robotronik/robot-sumo/mecanique/freecad_model/robot_sumo_CN70_holder_part.fcstd

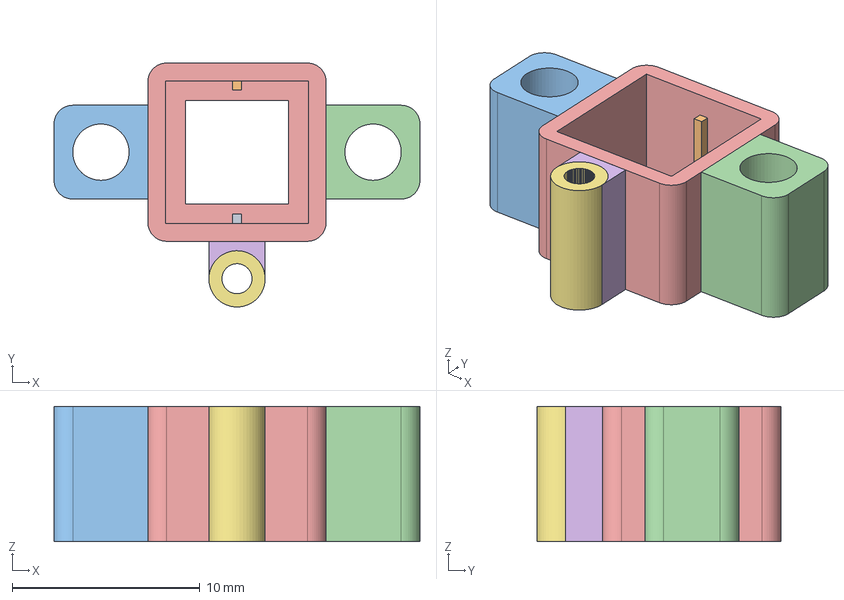
[picture p1: CAD file, 2017-09-19]
mecanique/freecad_model/robot_sumo_CN70_holder_part.fcstd
19.5 x 13.0 x 7.20 mm
sensor_guidance_1
sensor_guidance_2
