robotronik/robot-sumo/mecanique/robot-sumo-stl/support_pololu_3-8inch_ball_caster.stl

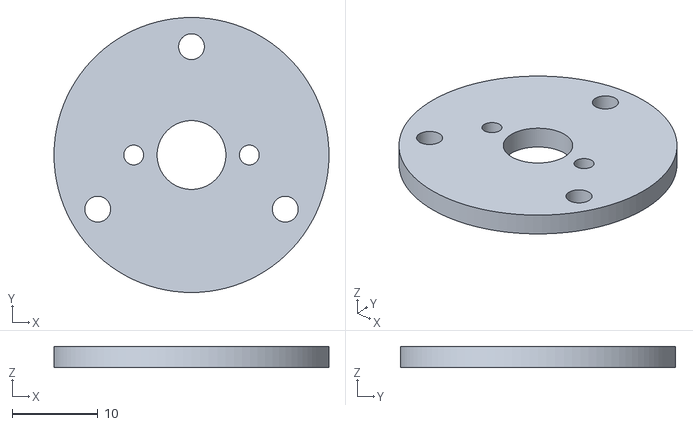
[picture p2: CAD file, 2017-09-06]
mecanique/robot-sumo-stl/support_pololu_3-8inch_ball_caster.stl
32.0 x 32.0 x 2.50
