robotronik/robot-sumo/mecanique/freecad_model/robot_sumo_motor_fix.fcstd

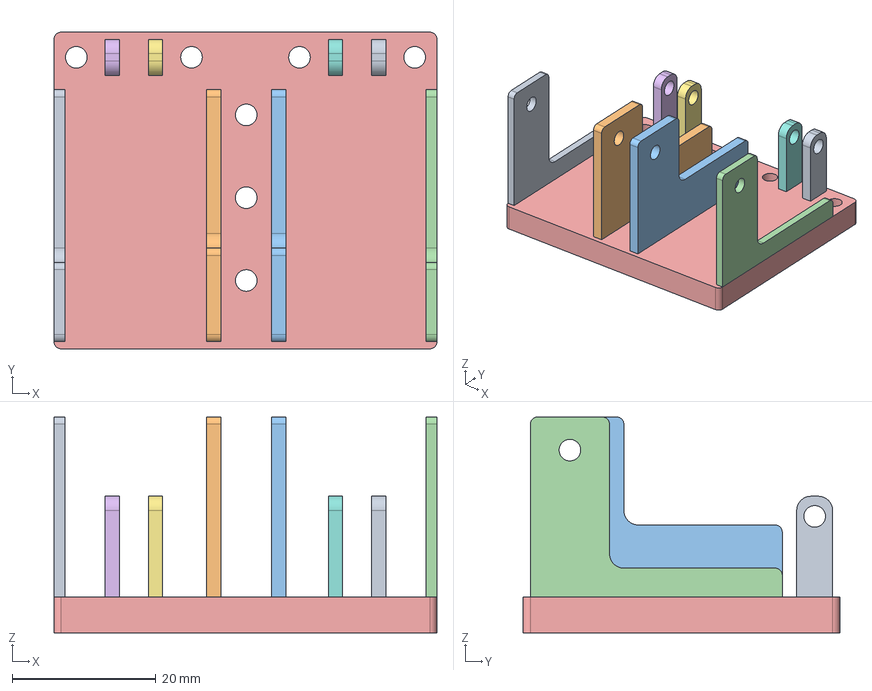
[picture p3: CAD file, 2017-07-28]
mecanique/freecad_model/robot_sumo_motor_fix.fcstd
53.2 x 44.0 x 30.0 mm
