robotronik/robot-sumo/mecanique/freecad_model/robot_sumo_CN70_block_part.fcstd

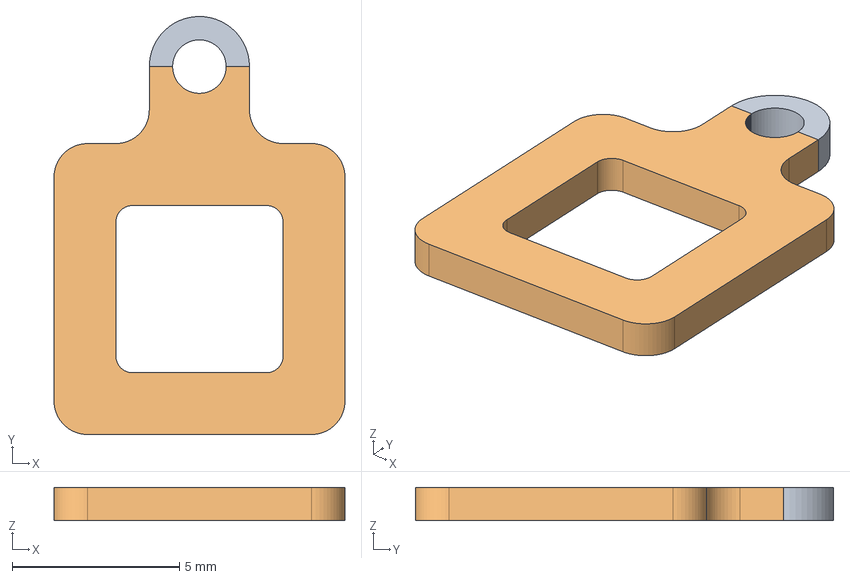
[picture p4: CAD file, 2017-07-26]
mecanique/freecad_model/robot_sumo_CN70_block_part.fcstd
8.70 x 12.5 x 1.00 mm
