robotronik/robot-sumo/mecanique/freecad_model/robot_sumo_base.fcstd

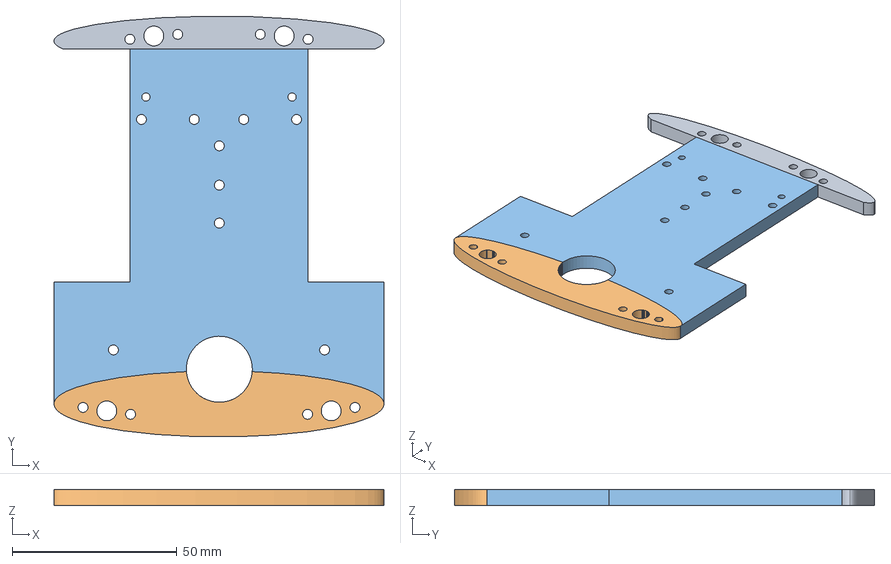
[picture p5: CAD file, 2017-07-25]
mecanique/freecad_model/robot_sumo_base.fcstd
100.0 x 127.4 x 5.00 mm
front_color_sensor_fix_holes
