robotronik/robot-sumo/mecanique/support_capteur_US_v2.scad

$fn=100;
use <capteurUS_HCSR04.scad>;
use <BezierScad/BezierScad.scad>

%translate([7.45,1,5])mirror([0,0,0])import ("freecad_model/robot_sumo_US_sensor_holder.stl");

//new fix 2017

diam_vis=1.5;

module backplate(L,H,e){

     difference(){
	  union(){
	       translate([-2,-(H-21),0])cube([L,H,e]);
	       translate([0.85,0.85,0])cylinder(d=diam_vis+2,h=e+2);
	       translate([45-0.85,0.85,0])cylinder(d=diam_vis+2,h=e+2);
	       translate([0.85,20-0.85,0])cylinder(d=diam_vis+2,h=e+2);
	       translate([45-0.85,20-0.85,0])cylinder(d=diam_vis+2,h=e+2);
	  }
	  minkowski(){
	       translate([(45-17)/2,-3.5+0.1+21,-0.1])cube([17,3.5,e+0.2]); // not interference with header
	       cylinder(d=3,h=e+0.2);
	  }
	  // screw hole
	  translate([0.85,0.85,-0.1])cylinder(d=diam_vis,h=e+2.2);
	  translate([45-0.85,0.85,-0.1])cylinder(d=diam_vis,h=e+2.2);
	  translate([0.85,20-0.85,-0.1])cylinder(d=diam_vis,h=e+2.2);
	  translate([45-0.85,20-0.85,-0.1])cylinder(d=diam_vis,h=e+2.2);
	  minkowski(){
	  translate([(45-30)/2,21-10-H/2+3,-0.1])cube([30,10,e+0.2]); // less PLA used
	  cylinder(d=2,h=e+0.2);
	  }
     }

     // fixation backplate

     translate([-2,-(H-18),0])cube([L,3,e]);
     difference(){
	  union(){
	       translate([-2,-(H-18),-10.5])cube([5,e,10.5]);
	       translate([-7+L,-(H-18),-10.5])cube([5,e,10.5]);
	  }
	  translate([0.35,0,-7.5])rotate([90,0,0])cylinder(d=2.5,h=10);
	  translate([-4.35+L,0,-7.5])rotate([90,0,0])cylinder(d=2.5,h=10);
	  
     }
}

module cable_management(L,l,h,e){

     cube([L,l,e]);
     cube([2,h,e]);
     translate([0,h,0])cube([L-2,e,e]);

}

module frontplate(L,H,e){
     difference(){
	  
	       union(){
		    minkowski(){
	       translate([-2,-(H-21),0])cube([L,H,e]);
	       cylinder(d=1.5,h=0.001);
	       }
	       translate([0.85,0.85,-3.5])cylinder(d=diam_vis+2,h=e+2);
	       translate([45-0.85-1,0.85,-3.5])cylinder(d=diam_vis+2,h=e+2);
	       translate([0.85,20-0.85,-3.5])cylinder(d=diam_vis+2,h=e+2);
	       translate([45-0.85-1,20-0.85,-3.5])cylinder(d=diam_vis+2,h=e+2);
	       translate([-2,-(H-18),0])cube([L,3,e]);
	  }

	  // screw hole
	  translate([0.85,0.85,-0.1-3.5])cylinder(d=diam_vis,h=e+2.2+3);
	  translate([45-0.85-1,0.85,-0.1-3.5])cylinder(d=diam_vis,h=e+2.2+3);
	  translate([0.85,20-0.85,-0.1-3.5])cylinder(d=diam_vis,h=e+2.2+3);
	  translate([45-0.85-1,20-0.85,-0.1-3.5])cylinder(d=diam_vis,h=e+2.2+3);
	  translate([45/2,10,-0.1])rotate([0,0,-90])cylinder(d=7,h=e+0.2,$fn=3); // decoration ^^
	  
	  translate([42.5,0,-0.1])rotate([0,0,-90])linear_extrude(height = e+0.2) 
	  BezLine([
	     [0,-12], [5, -20], [0,-28]
	     ], width = [3, 3], resolution = 5, centered = true);
	  
	      translate([9.5,10,-0.1]) cylinder(d=18,h=e+0.2);
	      translate([45-9.5,10,-0.1]) cylinder(d=18,h=e+0.2);
	  }

     // fixation frontplate

     
     difference(){
	  union(){
	       translate([-2,-(H-18),-15.5])cube([5,e,15.5]);
	       translate([-7+L,-(H-18),-15.5])cube([5,e,15.5]);
	       translate([-8,5,0])cable_management(6,2,7,2);
	       translate([L+4,5,0])mirror([1,0,0])cable_management(6,2,7,2);
	  }
	  translate([0.35,0,-7.5-5])rotate([90,0,0])cylinder(d=2.5,h=10);
	  translate([-4.35+L,0,-7.5-5])rotate([90,0,0])cylinder(d=2.5,h=10);
	  
     }
     
}

//capteurUS_HCSR04(100);
//translate([0,0,-4])backplate(49,23,2);
translate([0,0,5])frontplate(48,23,2);
//#translate([0,0,7])cube([5,5,5]);
