robotronik/robot-sumo/mecanique/support_pololu_3-8inch_ball_caster.scad

$fn=100;

module support_pololu_951_ball_caster(e,H){

     difference(){
     union(){	
	  cylinder(d=32,h=e);
	  translate([0,0,0])rotate([0,0,0])cylinder(d=8,h=e+H);
	  	   translate([1.65+2.3/2-19.05/2,0,0])cylinder(d=2.3+2,h=e+H);
	       translate([19.05/2-(1.65+2.3/2),0,0])cylinder(d=2.3+2,h=e+H);
	}
	  translate([0,0,0])rotate([0,0,0]){
	       for(i=[0:2]){translate([12.6*cos(i*120-30),12.6*sin(i*120-30),-0.01])cylinder(d=3,h=e+0.02);
	       }

	       translate([1.65+2.3/2-19.05/2,0,-0.01])cylinder(d=2.3,h=10.16+0.02);
	       translate([19.05/2-(1.65+2.3/2),0,-0.01])cylinder(d=2.3,h=10.16+0.02);
	       
	  }
	  

     }
     
     
}

support_pololu_951_ball_caster(2.5,3);
