robotronik/robot-sumo/(list of files, cad)

Other CAD files:
mecanique/Support_capteurCNY70.scad
mecanique/support_moteur_v2.scad
