robotronik/robot-sumo/electronique/PCB/Robot_sumo.kicad_pcb

## KiCad design electronique/PCB/Robot_sumo.kicad_pcb (2017-09-20)

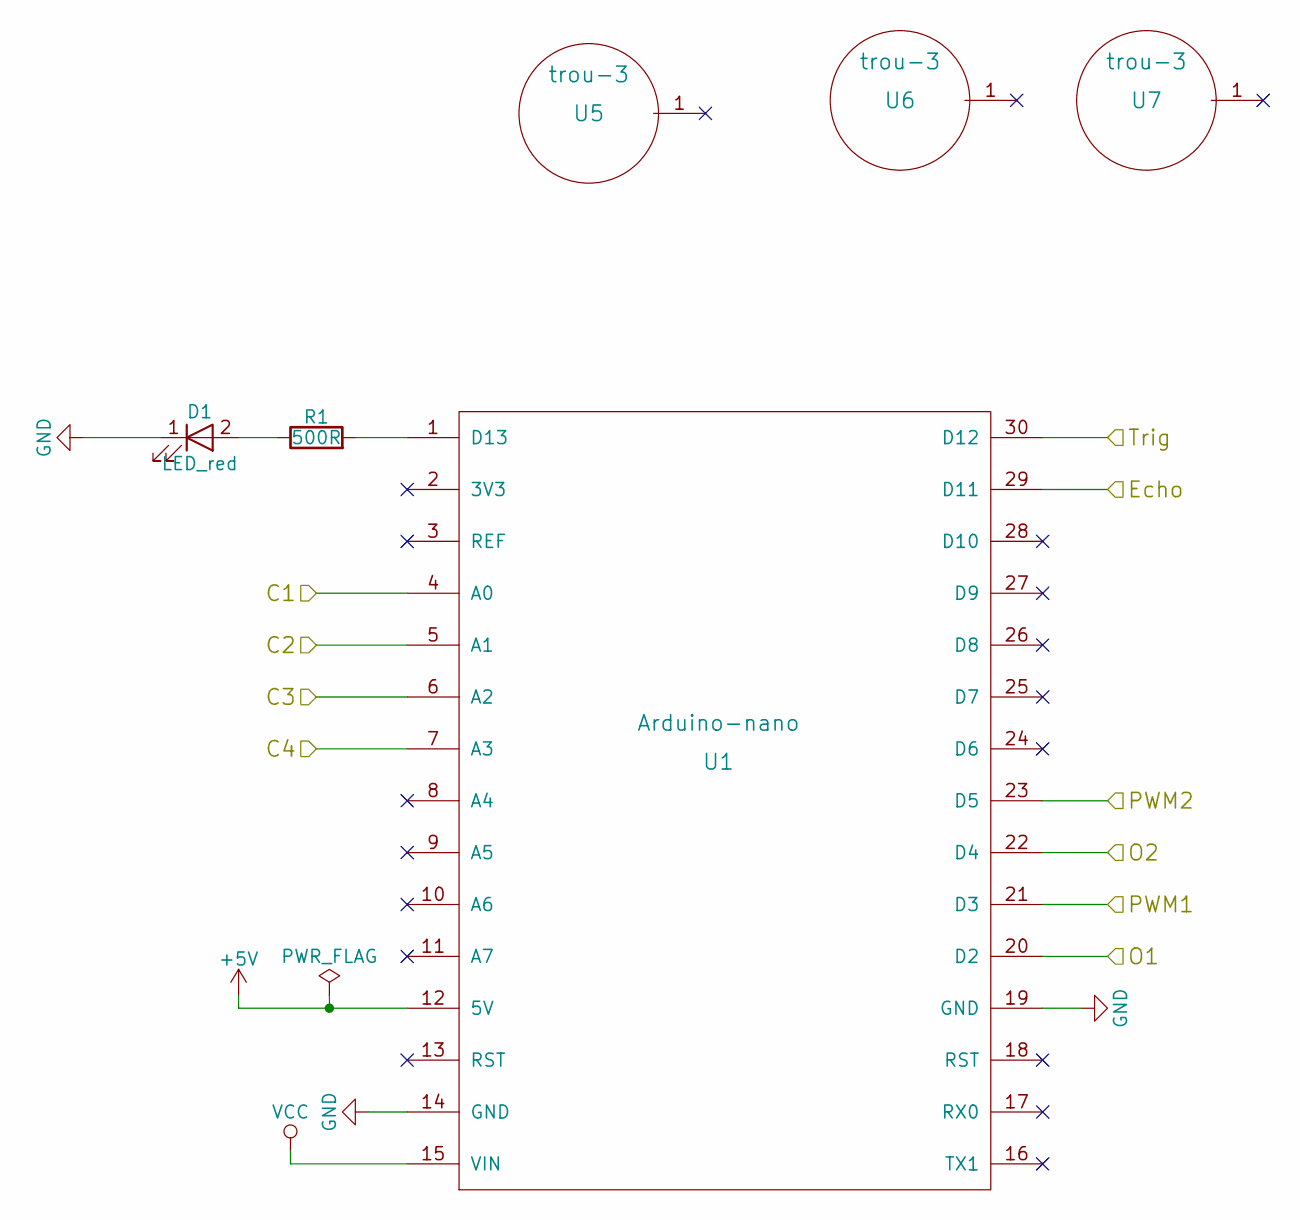
[picture p6: schematic uC-part.sch]

Parts:
D1: LED_red; LED_D5.0mm
R1: 500R; R4-LARGE_PADS
U1: Arduino-nano
U5, U6, U7: trou-3; Trou-3

Connections:
+5V: U1.12 (5V); also elsewhere on the board
/R-IR/C1: U1.4 (A0); also elsewhere on the board
/R-IR/C2: U1.5 (A1); also elsewhere on the board
/R-IR/C3: U1.6 (A2); also elsewhere on the board
/R-IR/C4: U1.7 (A3); also elsewhere on the board
/distance_sensor/Echo: U1.29 (D11); also elsewhere on the board
/distance_sensor/Trig: U1.30 (D12); also elsewhere on the board
/motor-part/O1: U1.20 (D2); also elsewhere on the board
/motor-part/O2: U1.22 (D4); also elsewhere on the board
/motor-part/PWM1: U1.21 (D3); also elsewhere on the board
/motor-part/PWM2: U1.23 (D5); also elsewhere on the board
GND: D1.1 (K), U1.14 (GND), U1.19 (GND); also elsewhere on the board
unnamed: D1.2 (A), R1.1
unnamed: R1.2, U1.1 (D13)
VCC: U1.15 (VIN); also elsewhere on the board

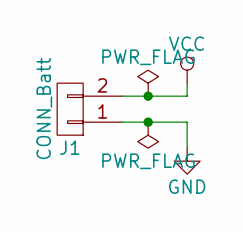
[picture p7: schematic power-part.sch]

Parts:
J1: CONN_Batt; Molex_KK-6410-02_02x2.54mm_Straight

Connections:
GND: J1.1; also elsewhere on the board
VCC: J1.2; also elsewhere on the board

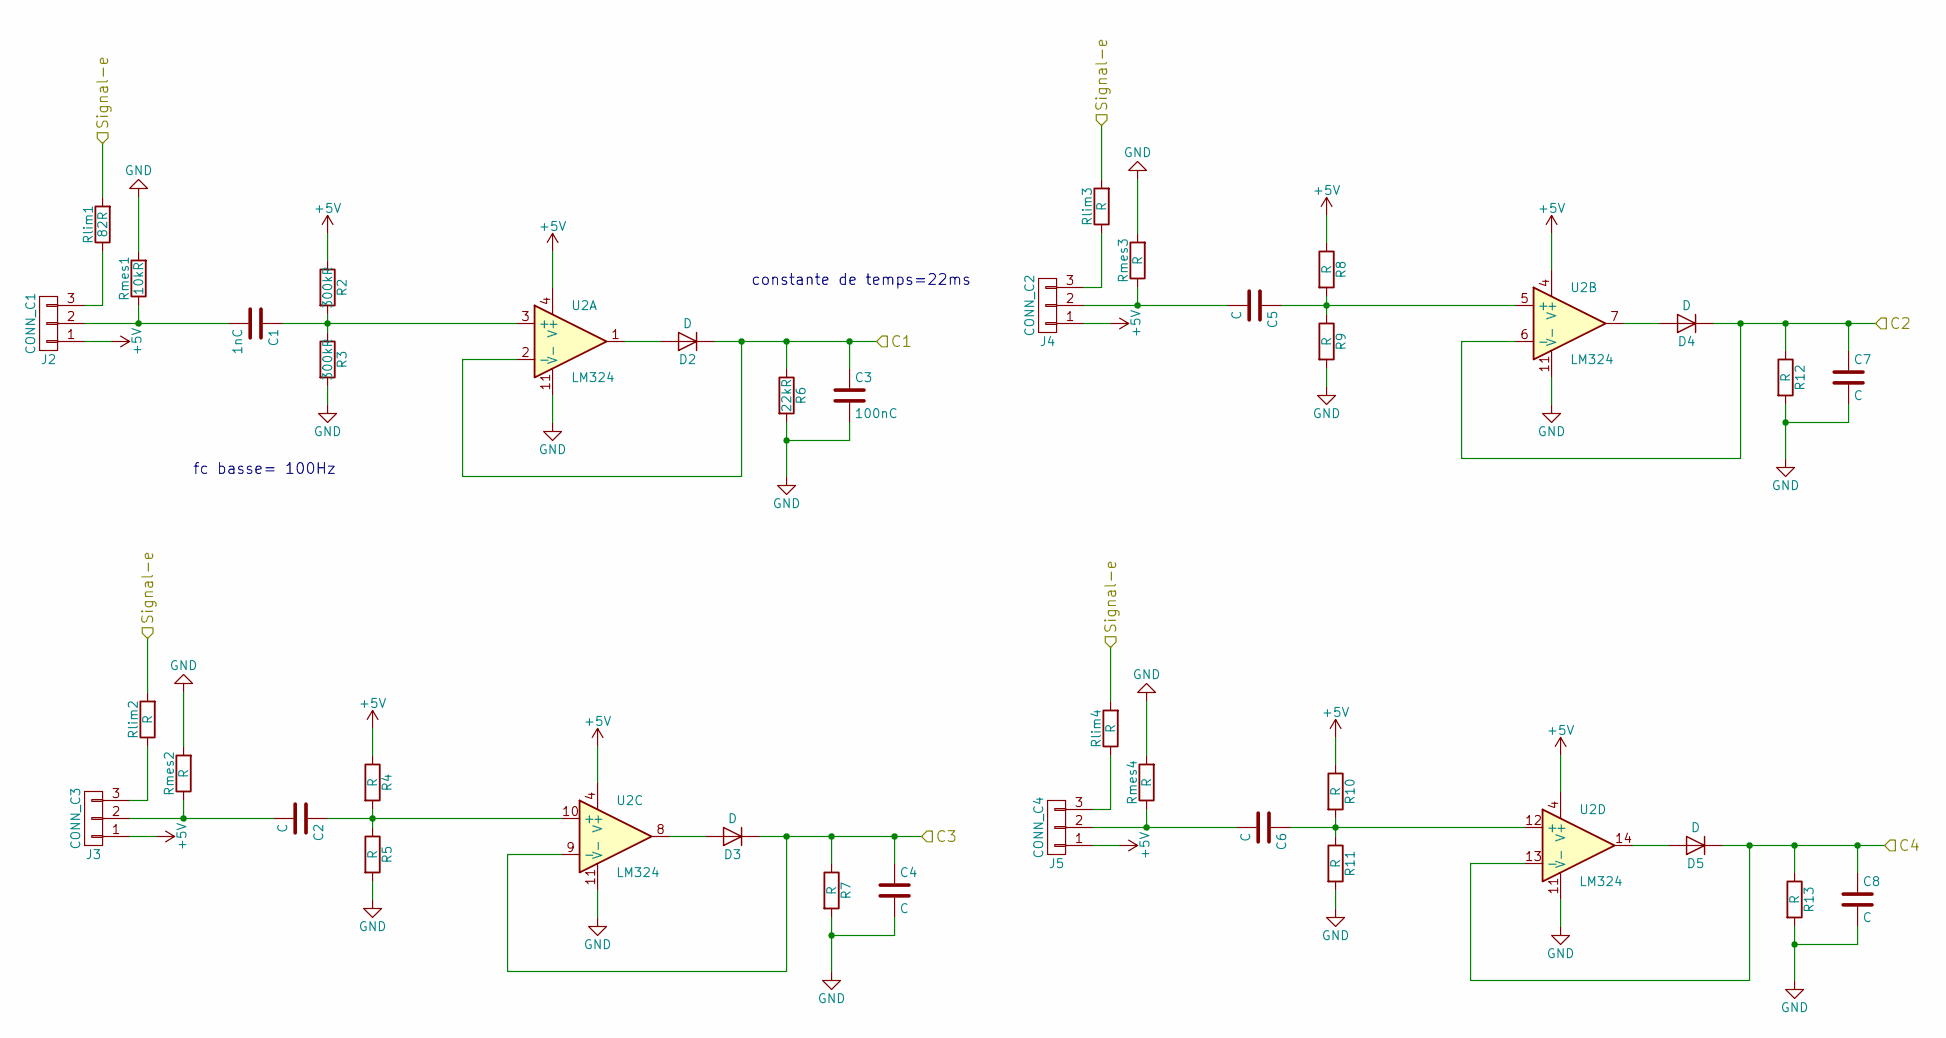
[picture p8: schematic R-IR.sch]

Parts:
C1: 1nC; C_Rect_L7.0mm_W2.5mm_P5.00mm
C2, C4, C5, C6, C7, C8: C; C_Rect_L7.0mm_W2.5mm_P5.00mm
C3: 100nC; C_Rect_L7.0mm_W2.5mm_P5.00mm
D2, D3, D4, D5: D; D4
J2: CONN_C1; Molex_KK-6410-03_03x2.54mm_Straight
J3: CONN_C3; Molex_KK-6410-03_03x2.54mm_Straight
J4: CONN_C2; Molex_KK-6410-03_03x2.54mm_Straight
J5: CONN_C4; Molex_KK-6410-03_03x2.54mm_Straight
R2, R3: 300kR; R4-LARGE_PADS
R4, R5, R7, R8, R9, R10, R11, R12, R13: R; R4-LARGE_PADS
R6: 22kR; R4-LARGE_PADS
Rlim1: 82R; R4-LARGE_PADS
Rlim2, Rlim3, Rlim4: R; R4-LARGE_PADS
Rmes1: 10kR; R4-LARGE_PADS
Rmes2, Rmes3, Rmes4: R; R4-LARGE_PADS
U2: LM324; DIP-14_W7.62mm_Socket_LongPads

Connections:
+5V: J2.1, J3.1, J4.1, J5.1, R2.1, R4.1, R8.1, R10.1, U2.4 (V+); also elsewhere on the board
/R-IR/C1: C3.1, D2.1 (K), R6.1, U2.2 (-); also elsewhere on the board
/R-IR/C2: C7.1, D4.1 (K), R12.1, U2.6 (-); also elsewhere on the board
/R-IR/C3: C4.1, D3.1 (K), R7.1, U2.9 (-); also elsewhere on the board
/R-IR/C4: C8.1, D5.1 (K), R13.1, U2.13 (-); also elsewhere on the board
/R-IR/Signal-e: Rlim1.2, Rlim2.2, Rlim3.2, Rlim4.2; also elsewhere on the board
GND: C3.2, C4.2, C7.2, C8.2, R3.2, R5.2, R6.2, R7.2, R9.2, R11.2, R12.2, R13.2, Rmes1.2, Rmes2.2, Rmes3.2, Rmes4.2, U2.11 (V-); also elsewhere on the board
unnamed: C1.1, R2.2, R3.1, U2.3 (+)
unnamed: C1.2, J2.2, Rmes1.1
unnamed: C2.1, R4.2, R5.1, U2.10 (+)
unnamed: C2.2, J3.2, Rmes2.1
unnamed: C5.1, R8.2, R9.1, U2.5 (+)
unnamed: C5.2, J4.2, Rmes3.1
unnamed: C6.1, R10.2, R11.1, U2.12 (+)
unnamed: C6.2, J5.2, Rmes4.1
unnamed: D2.2 (A), U2.1
unnamed: D3.2 (A), U2.8
unnamed: D4.2 (A), U2.7
unnamed: D5.2 (A), U2.14
unnamed: J2.3, Rlim1.1
unnamed: J3.3, Rlim2.1
unnamed: J4.3, Rlim3.1
unnamed: J5.3, Rlim4.1

Notes on the sheet:
fc basse= 100Hz
constante de temps=22ms

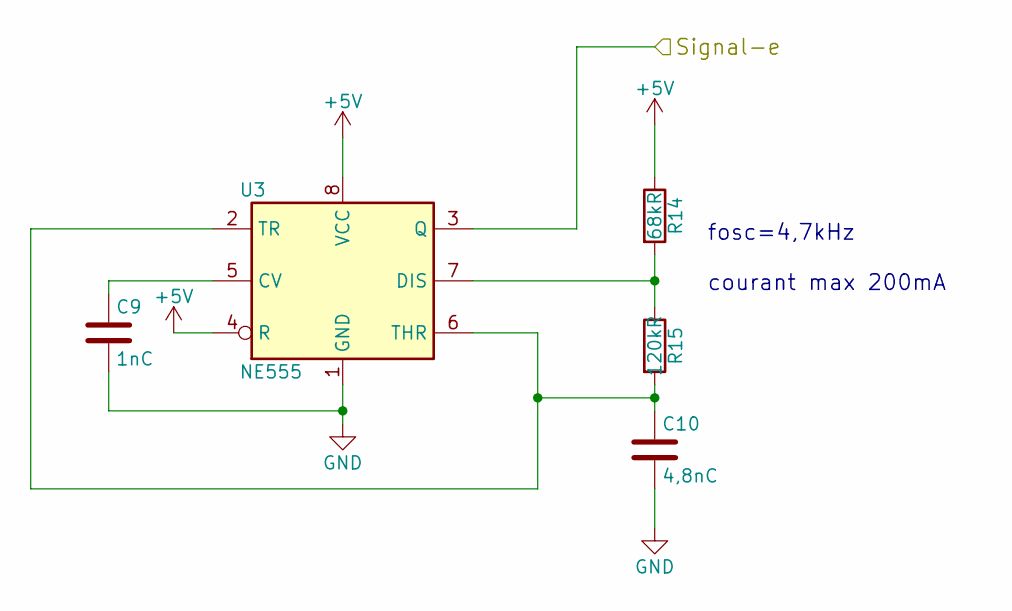
[picture p9: schematic T-IR.sch]

Parts:
C9: 1nC; C_Rect_L7.0mm_W2.5mm_P5.00mm
C10: 4,8nC; C_Rect_L7.0mm_W2.5mm_P5.00mm
R14: 68kR; R4-LARGE_PADS
R15: 120kR; R4-LARGE_PADS
U3: NE555; DIP-8_W7.62mm_Socket_LongPads

Connections:
+5V: R14.1, U3.4 (R), U3.8 (VCC); also elsewhere on the board
/R-IR/Signal-e: U3.3 (Q); also elsewhere on the board
GND: C9.2, C10.2, U3.1 (GND); also elsewhere on the board
unnamed: C9.1, U3.5 (CV)
unnamed: C10.1, R15.2, U3.2 (TR), U3.6 (THR)
unnamed: R14.2, R15.1, U3.7 (DIS)

Notes on the sheet:
fosc=4,7kHz courant max 200mA

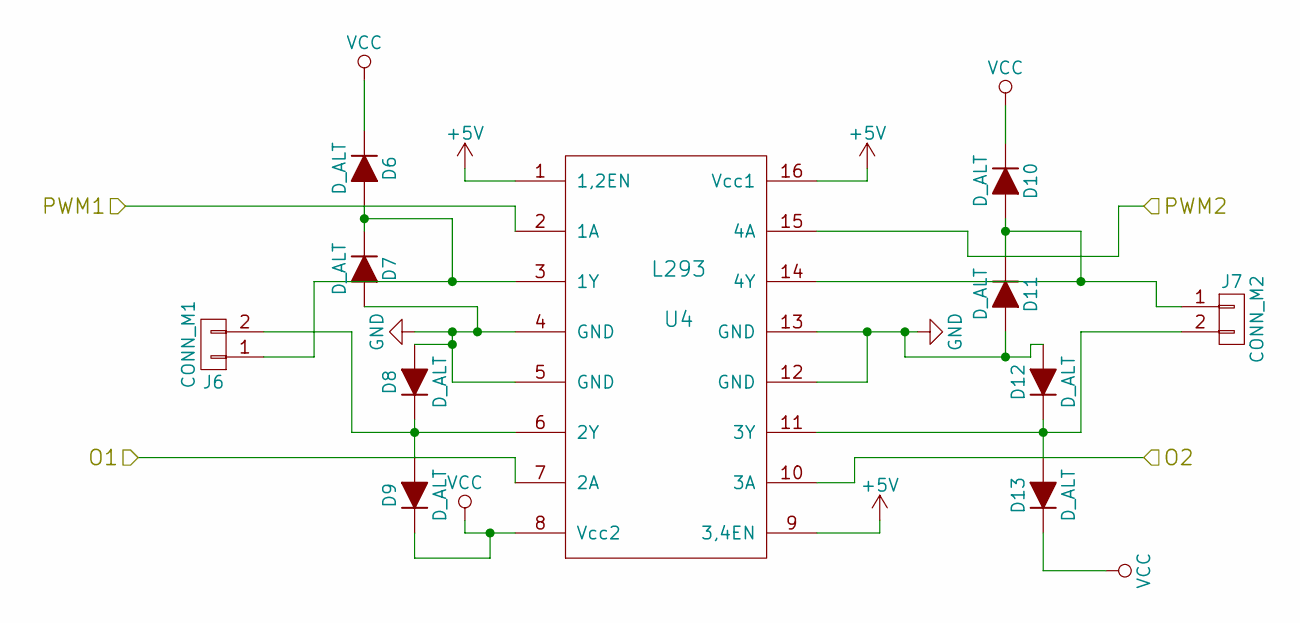
[picture p10: schematic motor-part.sch]

Parts:
D6, D7, D8, D9, D10, D11, D12, D13: D_ALT; D4
J6: CONN_M1; Molex_KK-6410-02_02x2.54mm_Straight
J7: CONN_M2; Molex_KK-6410-02_02x2.54mm_Straight
U4: L293; DIP-16_W7.62mm_Socket_LongPads

Connections:
+5V: U4.1 (1,2EN), U4.9 (3,4EN), U4.16 (Vcc1); also elsewhere on the board
/motor-part/O1: U4.7 (2A); also elsewhere on the board
/motor-part/O2: U4.10 (3A); also elsewhere on the board
/motor-part/PWM1: U4.2 (1A); also elsewhere on the board
/motor-part/PWM2: U4.15 (4A); also elsewhere on the board
GND: D7.2 (A), D8.2 (A), D11.2 (A), D12.2 (A), U4.4 (GND), U4.5 (GND), U4.12 (GND), U4.13 (GND); also elsewhere on the board
unnamed: D6.2 (A), D7.1 (K), J6.1, U4.3 (1Y)
unnamed: D8.1 (K), D9.2 (A), J6.2, U4.6 (2Y)
unnamed: D10.2 (A), D11.1 (K), J7.1, U4.14 (4Y)
unnamed: D12.1 (K), D13.2 (A), J7.2, U4.11 (3Y)
VCC: D6.1 (K), D9.1 (K), D10.1 (K), D13.1 (K), U4.8 (Vcc2); also elsewhere on the board

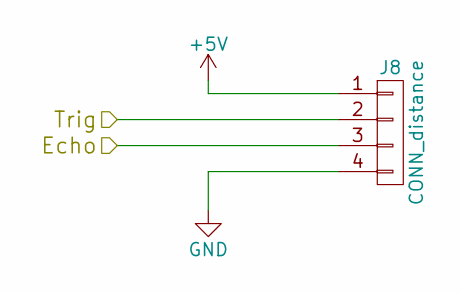
[picture p11: schematic distance_sensor.sch]

Parts:
J8: CONN_distance; Molex_KK-6410-04_04x2.54mm_Straight

Connections:
+5V: J8.1; also elsewhere on the board
/distance_sensor/Echo: J8.3; also elsewhere on the board
/distance_sensor/Trig: J8.2; also elsewhere on the board
GND: J8.4; also elsewhere on the board

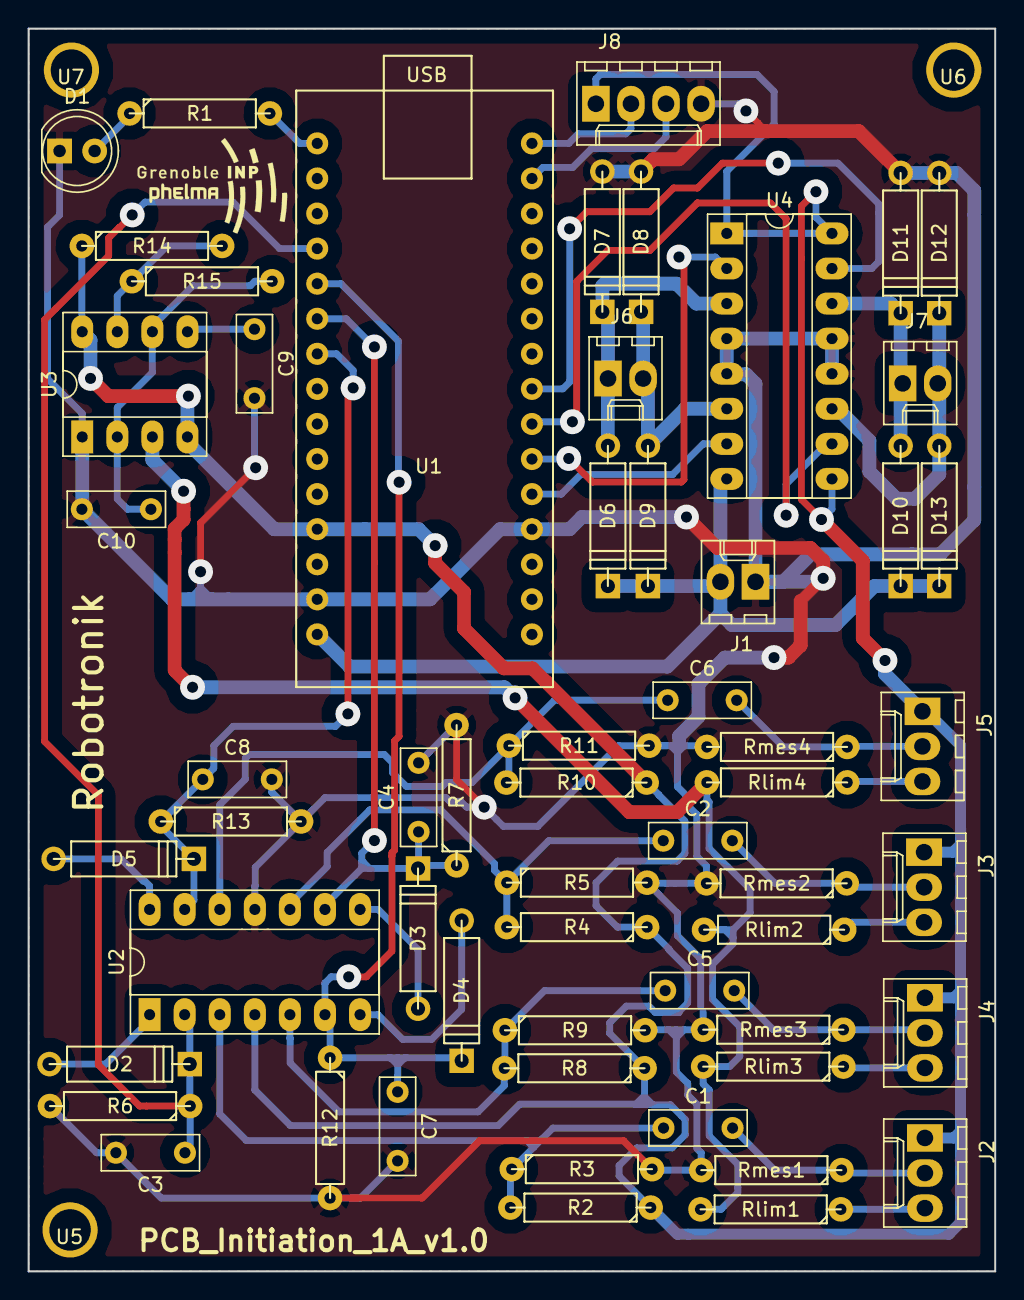
[picture p12: board Robot_sumo.kicad_pcb from above]

Board: 2 copper layers, 70.0 x 90.0 mm, 61 parts (0 on the bottom side), 39 nets.
