robotronik/robot-sumo/programmation/robot_sumo/pins.h

#ifndef PINS_HEADER
#define PINS_HEADER

//LED système
#define LED 13 //LED_BUILTIN

//Ultrasons
#define TRIG 12
#define ECHO 11

//Infrarouge
#define IR_1 A0
#define IR_2 A1
#define IR_3 A2
#define IR_4 A3

//Moteurs
#define PWM_1 3
#define DIR_1 2
#define PWM_2 5
#define DIR_2 4

#endif
