robotronik/robot-sumo/(commit log)

2016-09-06 Modèle de la roue du moteur chinois
    [moteur.scad]
2016-09-06 3eme roue du robot
    [roue_omni.scad]
2016-09-06 Fichier Openscad de la carte Arduino Nano
    [nano.scad]
2016-09-06 Fichier Openscad des pins pour la nano
    [pinoche.scad]
2016-09-06 modelisation capteur ultrason
    [capteurUS_HCSR04.scad]
2016-09-07 modelasation amelioree + ajout couleurs
    [capteurUS_HCSR04.scad]
2016-09-08 Fichier Openscad de la breadboard
    [breadboard.scad]
2016-09-08 Aperçu général en main
    [main.scad, moteur.scad, roue_omni.scad]
2016-09-08 Passage de nano, pinoche et breadboard en modules
    [breadboard.scad, nano.scad, pinoche.scad]
2016-09-08 indentation + passage en modules
    [capteurUS_HCSR04.scad, nano.scad, pinoche.scad]
2016-09-13 modelisation base + robot + ajout capteur CNY70 + choix pour modules inclus dans main
    [breadboard.scad, capteurUS_HCSR04.scad, capteur_CNY70.scad, main.scad, moteur.scad, nano.scad, pinoche.scad, roue_omni.scad]
2016-09-15 ajout performance fix
    [Robot.scad, breadboard.scad]
2016-09-15 ajout archive STL pour contourner blocage gitignore
2016-09-16 correction support moteur
    [main.scad]
2016-09-17 Correction support moteur + rectification modif base
    [main.scad]
2016-09-20 Plan de la base
2016-09-20 réorganisation du projet sumo
    [Robot.scad, breadboard.scad, capteurUS_HCSR04.scad, capteur_CNY70.scad, main.scad, moteur.scad, nano.scad, pinoche.scad]
2016-09-21 modif dimension capteurUS + modif element robot sumo
    [capteurUS_HCSR04.scad, main.scad]
2016-09-22 ajout support capteur infrarouge + piece anti-frottement roue/base + rendu complet robot
    [Support_capteurCNY70.scad, main.scad, wheel_spacer.scad]
2016-10-24 modicfication taille + ajout encoche
    [Support_capteurCNY70.scad, wheel_spacer.scad]
2017-06-27 new US sensor support
    [support_capteur_US_v2.scad]
2017-06-28 error correction + added a new US sensor support
    [support_capteur_US_v2.scad]
2017-06-28 added some funny stuff on US sensor support + added new motor support
    [main.scad, support_capteur_US_v2.scad, support_moteur_v2.scad]
2017-07-01 added new color sensor support + some fix on US sensor and motor support
    [main.scad, support_capteur_CNY70_v2.scad, support_capteur_US_v2.scad, support_moteur_v2.scad]
2017-07-09 added color sensor placement + beginning of pcb support
    [PCB_hole_footprint.scad, main.scad, support_PCB.scad, support_capteur_CNY70_v2.scad]
2017-07-10 added battery rack + end of PCB support
    [main.scad, support_PCB.scad, support_batterie.scad]
2017-07-11 added some <cable management> features
    [main.scad, support_PCB.scad, support_capteur_US_v2.scad]
2017-07-23 beginning of model convertion from openscad to freecad
    [robot_sumo_base.fcstd]
2017-07-25 end of base modelisation
    [robot_sumo_base.fcstd]
2017-07-26 added color sensor support parts
    [robot_sumo_CN70_block_part.fcstd, robot_sumo_CN70_holder_part.fcstd]
2017-07-28 added motor fix freecad model + corrected screw hole position on scad model
    [robot_sumo_motor_fix.fcstd, support_moteur_v2.scad]
2017-08-27 added stl file
2017-09-06 added pololu ball caster support openscad + stl file
    [support_pololu_3-8inch_ball_caster.scad, support_pololu_3-8inch_ball_caster.stl]
2017-09-19 added new ball caster + support + some dimension change
    [main.scad, pololu_3-8inch_ball_caster.scad, robot_sumo_CN70_holder_part.fcstd, support_PCB.scad, support_batterie.scad, support_capteur_US_v2.scad, support_pololu_3-8inch_ball_caster.scad]
2017-09-21 new values
    [R-IR.sch, T-IR.sch, uC-part.sch]
2017-10-09 Suppression de l293.pdf
2018-09-17 essai de simplification pour les 1a
2018-09-27 les fonctions de test marchent correctement
    [robot_sumo.h, robot_sumo_simplifie.h, robot_sumo_simplifie.ino]
